radekrudak/A-TinyClock/Photos/IMG_20220115_162410.jpg

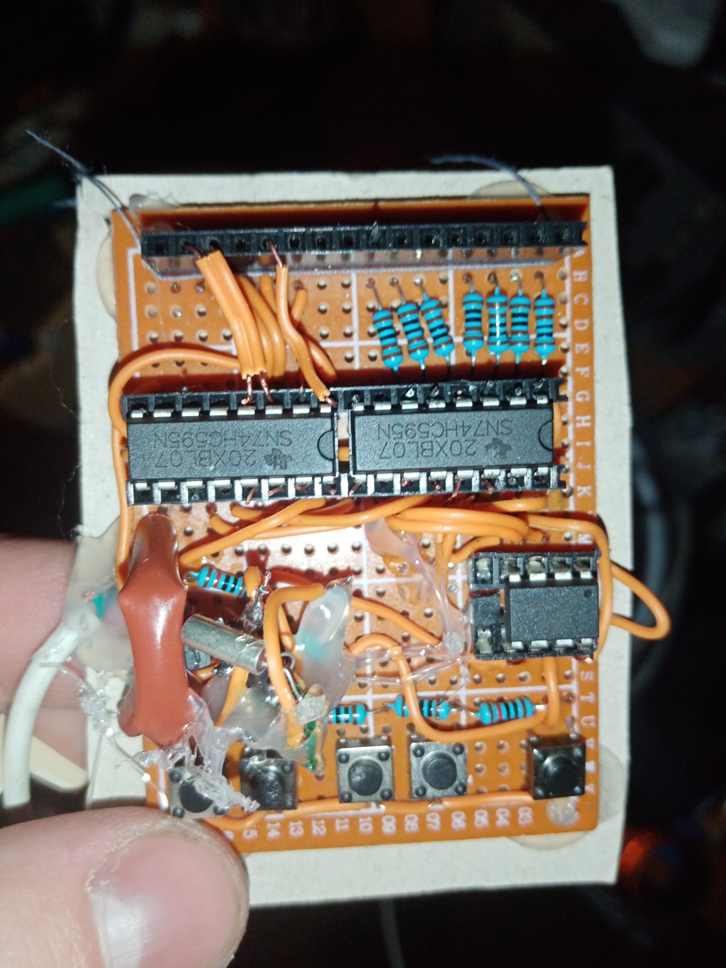
Photos/IMG_20220115_162410.jpg
