radekrudak/A-TinyClock/Photos/IMG_20220113_202635.jpg

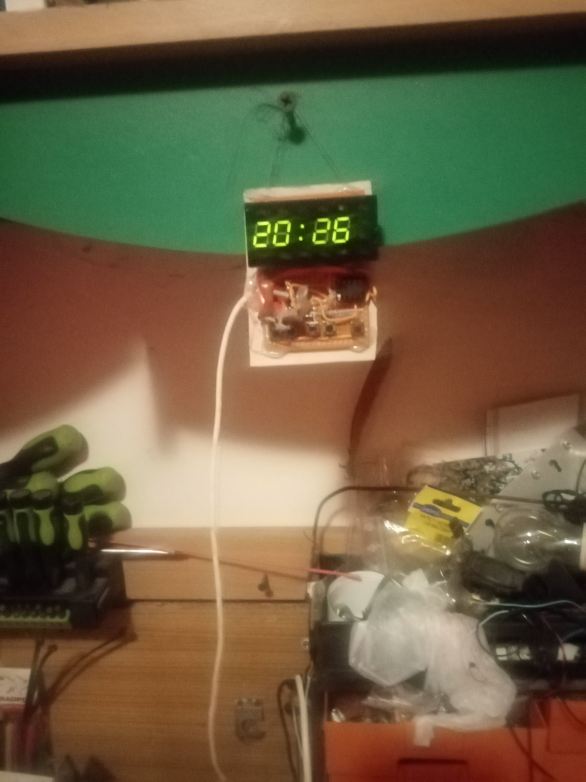
Photos/IMG_20220113_202635.jpg
