radekrudak/A-TinyClock/Photos/IMG_20220115_162339.jpg

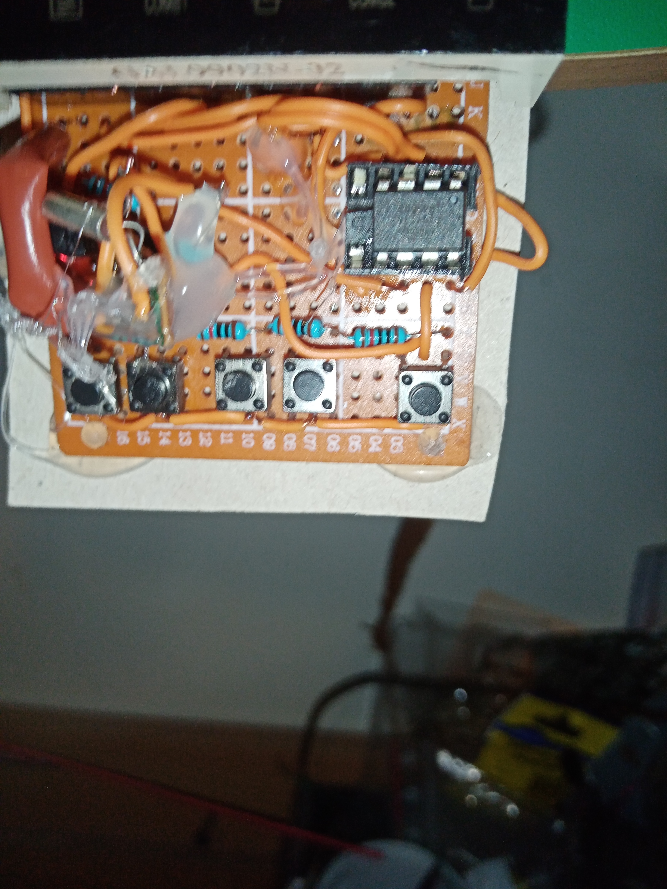
Photos/IMG_20220115_162339.jpg
