radekrudak/A-TinyClock/Photos/IMG_20220115_162343.jpg

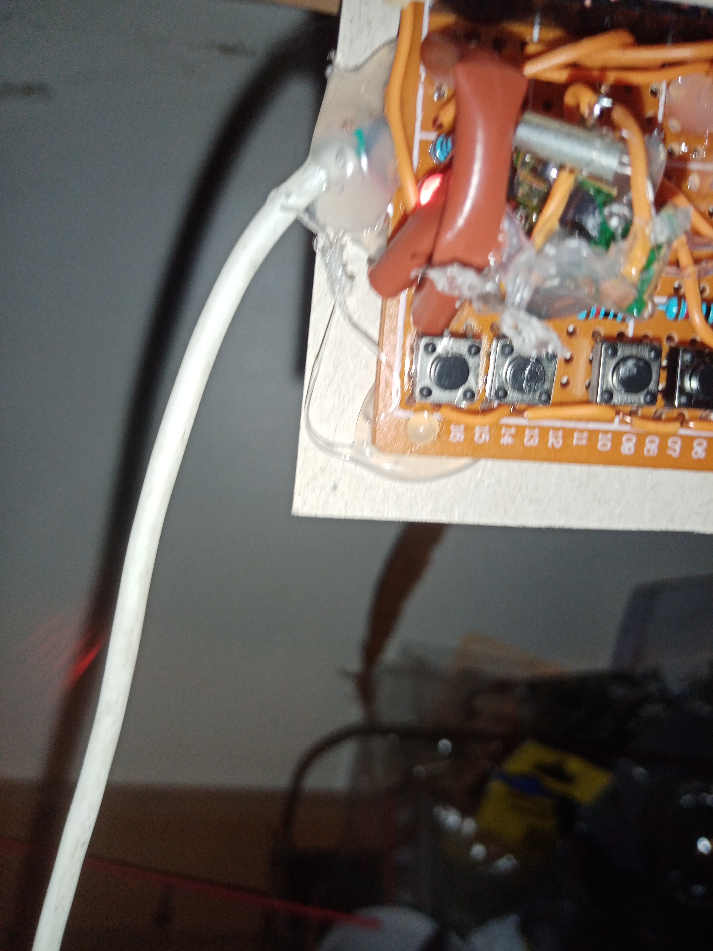
Photos/IMG_20220115_162343.jpg
