radekrudak/A-TinyClock/Photos/IMG_20220115_162348.jpg

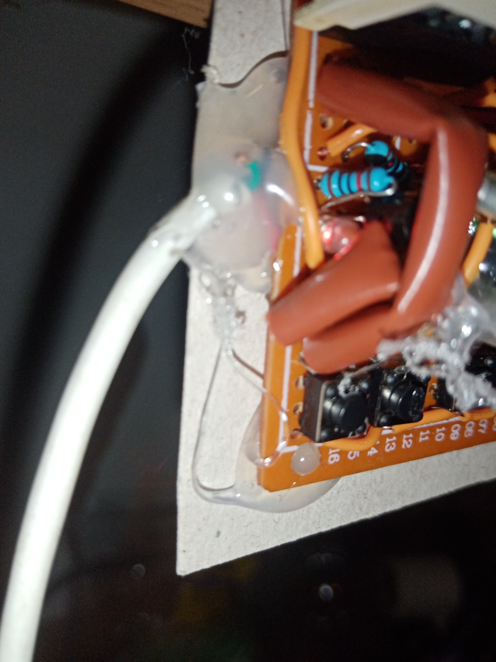
Photos/IMG_20220115_162348.jpg
