radekrudak/A-TinyClock/Photos/IMG_20220115_162414.jpg

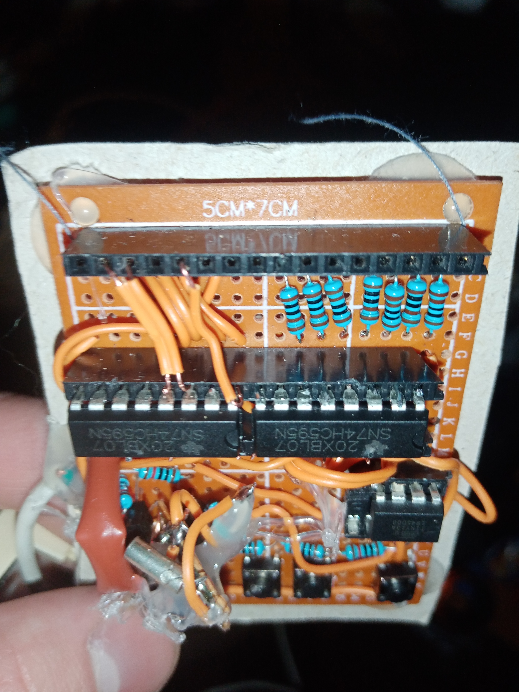
Photos/IMG_20220115_162414.jpg
