radekrudak/A-TinyClock/A_Tiny_clock_schematic.pdf

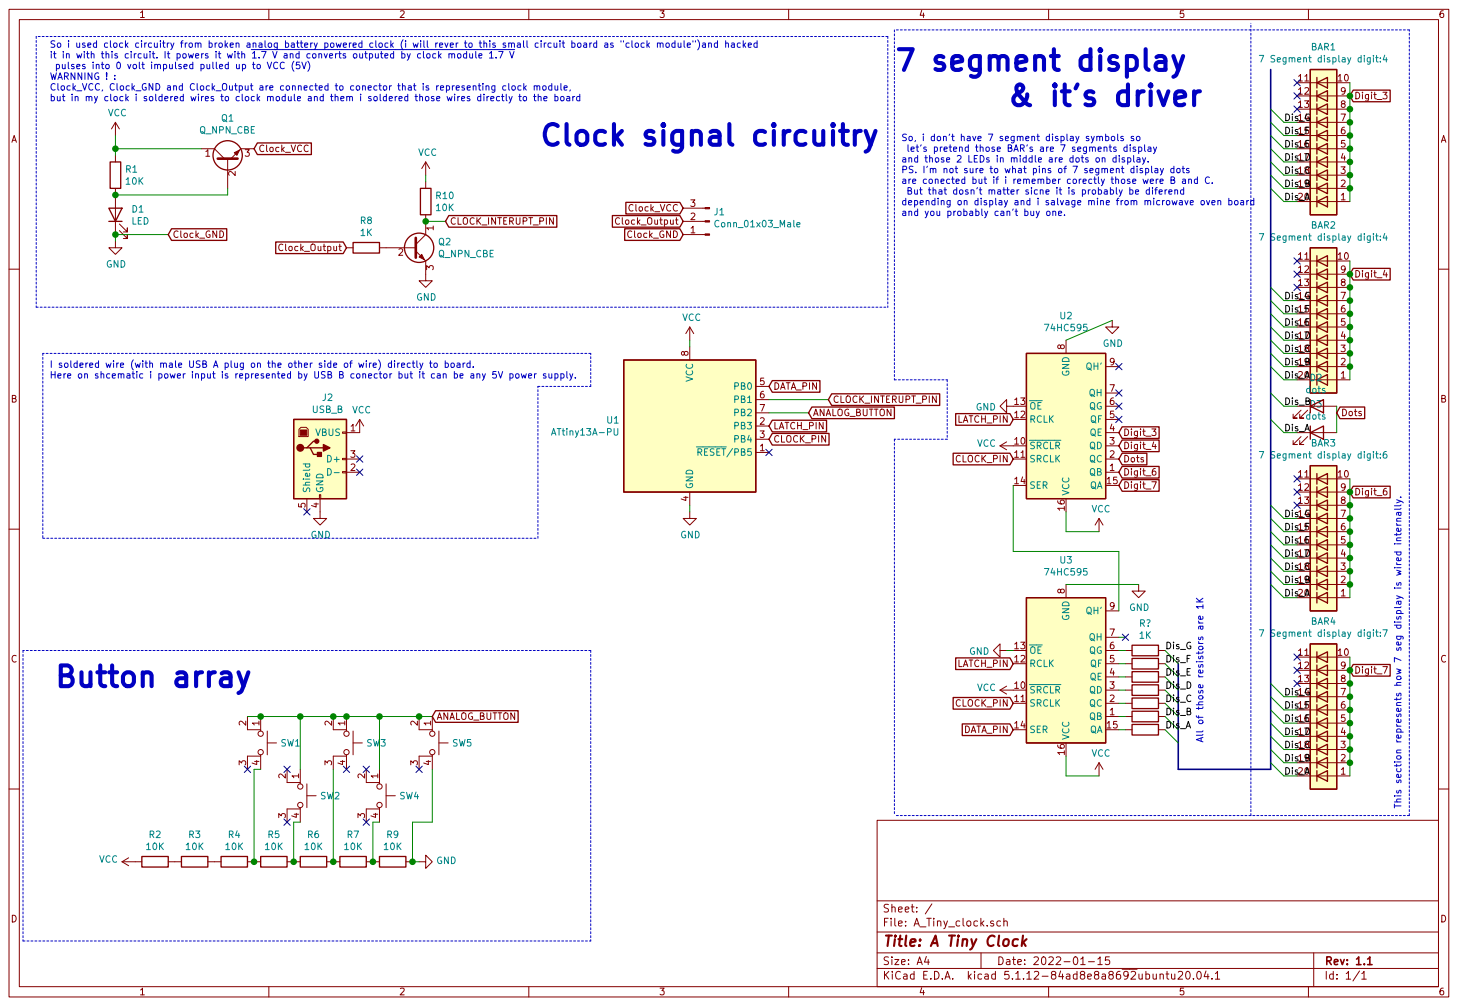
[picture p7: page 1]

So i used clock circuitry from broken analog battery powered clock (i will rever to this small circuit board as "clock module")and hacked
it in with this circuit. It powers it with 1.7 V and converts outputed by clock module 1.7 V
pulses into 0 volt impulsed pulled up to VCC (5V) WARNNING ! : Clock_VCC, Clock_GND and Clock_Output are connected to conector that is representing clock module,

9 BAR1
& it's driverAll of those resistors are 1K

but in my clock i soldered wires to clock module and them i soldered those wires directly to the board
VCC GND

So, i don't have 7 segment display symbols so
let's pretend those BAR's are 7 segments display
and those 2 LEDs in middle are dots on display.
PS. I'm not sure to what pins of 7 segment display dots
are conected but if i remember corectly those were B and C.
But that dosn't matter sicne it is probably be diferend
depending on display and i salvage mine from microwave oven board
and you probably can't buy one.

7 Segment display digit:4 GND GND

I soldered wire (with male USB A plug on the other side of wire) directly to board.
Here on shcematic i power input is represented by USB B conector but it can be any 5V power supply.

4 SW5 VCC QB 1 SRCLR 10 SRCLK 11 RCLK 12 OE 13 SER 14 QA 15 VCC 16 QC 2 QD 3 QE 4 QF 5 QG 6 QH 7 GND

Id: 1/1 Title: A Tiny Clock
