radekrudak/A-TinyClock/(commit log)

2022-01-15 A bit of Clean Up & more comments
    Removed setup of serial with is no longer used, also added comments explaining why i put button press detection in comp ANA_COMP_vect
2022-01-15 Maing schematic a bit less bad
    Clean-up, better descriptions and removed all connection errors.
    [Microwave_clock.sch]
2022-01-15 Part of renaming process
    I delete those files to upload them with different name
    [Microwave_clock.kicad_pcb, Microwave_clock.sch]
2022-01-15 Renaming
    Uploaded files previously deleted but with different names
    [A_Tiny_clock.kicad_pcb, A_Tiny_clock.sch]
2022-01-16 Updated schematic
    [A_Tiny_clock.sch]
2022-01-16 Added resistors in 7 seg dis section and claryfications
    [A_Tiny_clock.sch]
